OUSmartInfrastructure/PhotonBikeSensor/README.md

# PhotonBikeSensor
Bike sensor using a Particle Photon and serial camera

This includes the .ino script for the Particle Photon (BikeSensorv3.ino), as well as the python listener to gather data (startServer.py)
