OUSmartInfrastructure/PhotonBikeSensor/(commit log)

2018-04-10 Initial upload
    This image is corrected from what Fritzing has for the serial camera to match Adafuit's tutorial on the VC0706 image sensor.
2018-05-08 Added enclosure files
2018-05-08 Report on Sensor
